david-griffith/HotWaterController/IO board/PCB_SolarController.png

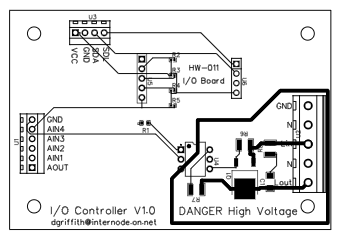
IO board/PCB_SolarController.png
