david-griffith/HotWaterController/IO board/SolarController 3D View.png

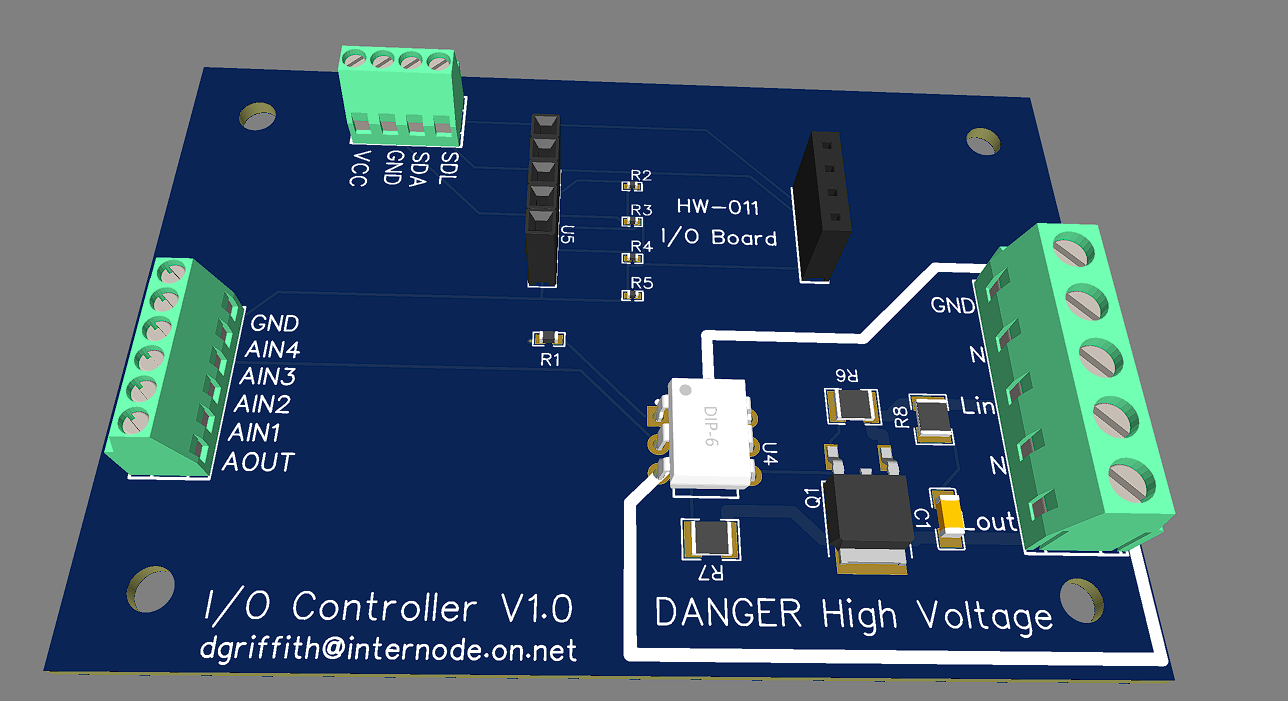
IO board/SolarController 3D View.png
