david-griffith/HotWaterController/IO board/BOM_PCB_SolarController_2_2023-12-30.csv

ID | Name | Designator | Footprint | Quantity | Manufacturer Part | Manufacturer | Supplier | Supplier Part | Price
1 | DB125-2.54-6P-GN | U1 | CONN-TH_DB125-2.54-6P-GN | 1 | DB125-2.54-6P-GN-S | DIBO(地博电气) | LCSC | C918124 | 0.547
2 | DW254R-11-04-85 | U6 | HDR-TH_4P-P2.54-V-F | 1 | DW254R-11-04-85 | DEALON(德艺隆) | LCSC | C2935898 | 0.05
3 | DB127V-5.0-5P-GN-S | U2 | CONN-TH_5P-P5.00_DB127V-5.0-5P-GN-S | 1 | DB127V-5.0-5P-GN-S | DIBO(地博电气) | LCSC | C430625 | 0.333
4 | DB125-2.54-4P-GN | U3 | CONN-TH_DB125-2.54-4P-GN | 1 | DB125-2.54-4P-GN-S | DIBO(地博电气) | LCSC | C918122 | 0.382
5 | DW254R-11-05-85 | U5 | CONN-TH_5P-P2.54_DEALON_DW254R-11-05-85 | 1 | DW254R-11-05-85 | DEALON(德艺隆) | LCSC | C2935899 | 0.055
6 | MOC3041M | U4 | DIP-6_L8.5-W6.4-P2.54-LS7.6-BL | 1 | MOC3041M | FAIRCHILD | LCSC | C8921 | 0.597
7 | 360Ω | R7 | R1210 | 1 | CR1210F360RP05 | Ever Ohms Tech | LCSC | C174466 | 0.016
8 | 330Ω | R6 | R1210 | 1 | 1210W2F3300T5E | UNI-ROYAL(Uniroyal Elec) | LCSC | C422327 | 0.01
9 | 1kΩ | R5,R4,R3,R2 | R0402 | 4 | PTFR0402B1K00N9 | ResistorToday | LCSC | C328418 | 0.124
10 | 160Ω | R1 | R0603 | 1 | AECR0603F160RK9 | ResistorToday | LCSC | C352364 | 0.005
11 | BT137S-800E_C2831693 | Q1 | TO-252-3_L6.5-W5.8-P4.60-LS9.9-BR | 1 | BT137S-800E | KY(韩景元) | LCSC | C2831693 | 0.117
12 | 33Ω | R8 | R1210 | 1 | 1210W2F330JT5E | Uniroyal Elec | LCSC | C407192 | 0.011
13 | 10nF | C1 | C1206 | 1 | GCM31B7U2E103JX01L | muRata(村田) | LCSC | C363962 | 0.134
