david-griffith/HotWaterController/IO board/Schematic_SolarController_2023-12-30.pdf

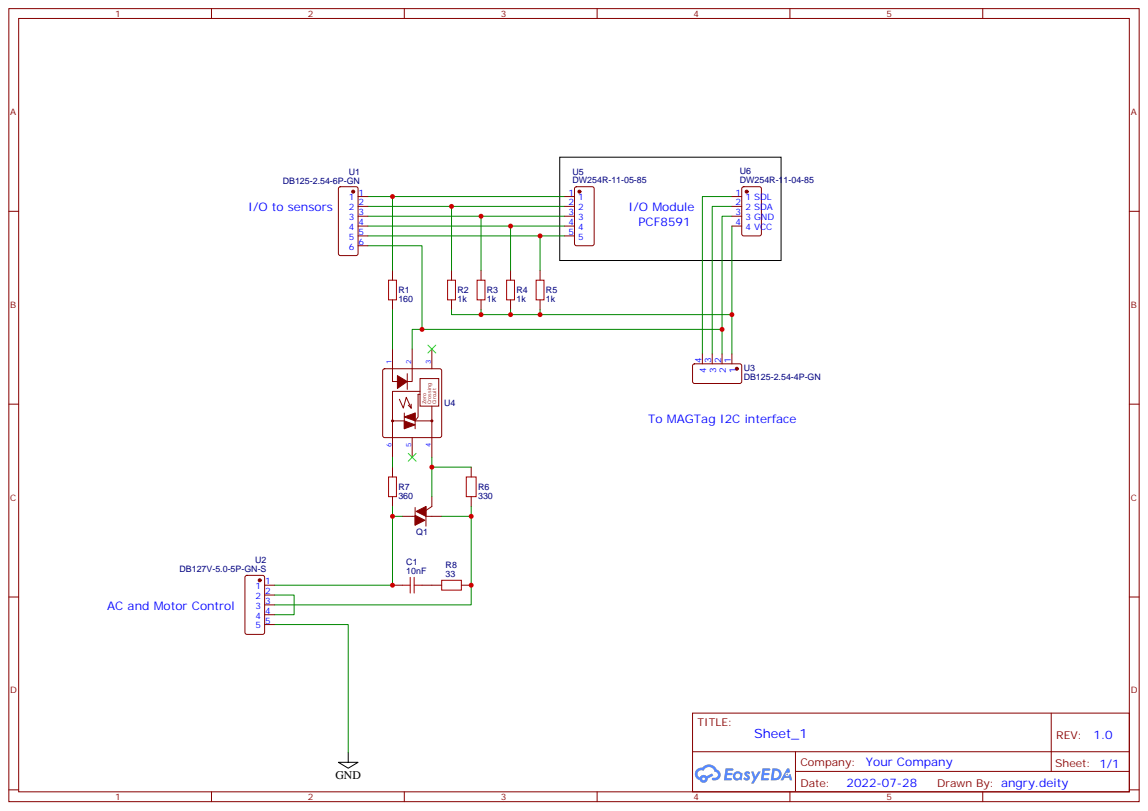
[picture p3: page 1]

AC and Motor Control

Drawn By: angry.deity
