david-griffith/HotWaterController/HotWaterController.ino

/* 
 HotWaterController program.
 Reads some analog sensors and controls a circulating pump to circulate water through solar collectors to efficiently heat a tank of water.
 A suite of Dallas Onewire sensors provide monitoring of other temperatures in the system.  
 We are using FreeRTOS to allow different tasks to run simultaneously.
 There is :
 A sensor reading task.
 A TFT display print task.
 A pump control task.
 A pump speed calculation task.
 A cloud update task.
*/
#include <FreeRTOS_SAMD51.h>
#include <SPI.h>
#include <WiFiNINA.h>
#include <OneWire.h>
#include <DallasTemperature.h>
#include <Adafruit_PCF8591.h>
#include "Adafruit_GFX.h"
#include "Adafruit_HX8357.h"
#include <ArduinoHA.h>

// Change the defines in this file to match your local settings!
#include "LocalSettings.h"

// A buffer for the task list in the loop function.
char ptrTaskList[250];

// OneWire bus is on pin 4
#define ONE_WIRE_BUS 4

// Reset the wifi module using pin 7
#define WIFI_RST 7

// PyPortal Titano TFT control
#define TFT_BACKLIGHT 25  // Set the backlight power
#define TFT_D0 34         // Data bit 0 pin (MUST be on PORT byte boundary)
#define TFT_WR 26         // Write-strobe pin (CCL-inverted timer output)
#define TFT_DC 10         // Data/command pin
#define TFT_CS 11         // Chip-select pin
#define TFT_RST 24        // Reset pin
#define TFT_RD 9          // Read-strobe pin
#define TFT_TE 12
Adafruit_HX8357 tft = Adafruit_HX8357(tft8bitbus, TFT_D0, TFT_WR, TFT_DC, TFT_CS, TFT_RST, TFT_RD);

// Mutex around print to avoid two threads trying to print at the same time.
SemaphoreHandle_t printMutex = xSemaphoreCreateMutex();
// Mutex around the ADC to avoid two threads accessing the PCF8591 chip at the same time.
SemaphoreHandle_t adcMutex = xSemaphoreCreateMutex();
// Mutex around the pumpSpeed variable to avoid the calculation and the pump drive threads from accessing the variable at the same time.
SemaphoreHandle_t speedMutex = xSemaphoreCreateMutex();

// Addesses of the oneWire sensors we are using.
// On bootup the program scans the bus and outputs these addresses on the serial port.
DeviceAddress owRoms[][8] = {
  { 0x28, 0xF7, 0xE2, 0x81, 0x94, 0x21, 0x06, 0x88 },
  { 0x28, 0xAB, 0x83, 0x7F, 0x94, 0x21, 0x06, 0x63 },
  { 0x28, 0xEE, 0x1D, 0xA2, 0x94, 0x21, 0x06, 0x74 },
  { 0x28, 0x62, 0xC7, 0x7F, 0x94, 0x21, 0x06, 0x9C },
  { 0x28, 0x7A, 0x5B, 0x85, 0x94, 0x21, 0x06, 0x9A },
};

// Sensor names.
// Ensure that the order of these names matches the owRom addresses above.
// Extra names are added on the end for the analog sensors and other bits of info.
char sensorNames[][40] = { "Ambient_Temperature",
                           "Outlet_Temperature",
                           "Inlet_Temperature",
                           "Panel_Inlet_Temperature",
                           "Panel_Outlet_Temperature",
                           "coldSensor",
                           "hotSensor",
                           "RSSI",
                           "pumpSpeed",
                           "wifiConnects",
                           "MQTTConnects",
                           "maxDiff" };

// The combined data from all sensors above is stored in this array.
float sensorData[12] = { 0, 0, 0, 0, 0, 0, 0, 0, 0, 0, 0, 0 };
// Pump speed from 0 to 100 percent.
uint8_t pumpSpeed = 0;
// Wifi stats.
uint16_t wifiConnects = 0;
uint16_t MQTTConnects = 0;
// Controller initial start and stop temperatures.
float START_MAX_DIFF = 8;
float START_MIN_DIFF = 4;


// Set up the A/D board
// This is actually a generic PCF8951 board I got off ebay running over I2C.
Adafruit_PCF8591 pcf = Adafruit_PCF8591();
#define ADC_REFERENCE_VOLTAGE 3.3

// Setup a oneWire instance to communicate with any OneWire devices (not just Maxim/Dallas temperature ICs)
OneWire oneWire(ONE_WIRE_BUS);

// Pass our oneWire reference to Dallas Temperature.
DallasTemperature sensors(&oneWire);

// Set up networking.
WiFiClient net;
HADevice device;
// MQTT subsystem
HAMqtt mqtt(net, device);

float sensorGet(const char* wantedName) {
  // A simple helper function to return the value given by the name
  // Just like a dictionary would.
  for (int i = 0; i < 12; i++) {
    if (strcmp(sensorNames[i], wantedName) == 0) return sensorData[i];
  }
  // Return nonsense value if not in the list.
  return -255;
}

void sensorSet(const char* sensorName, float sensorValue) {
  // Sets a value by it's name, like a dictionary.
  for (int i = 0; i < 12; i++) {
    if (strcmp(sensorNames[i], sensorName) == 0) {
      sensorData[i] = sensorValue;
    }
  }
}

float smooth(float smoothValue, float rawValue) {
  // returns a smoothed value by shifting the smoothed value 20 percent of the difference
  // between raw and smooth.
  // Initial load if smoothValue is zero
  if (smoothValue == 0.0) return rawValue * 0.95;
  float diff = rawValue - smoothValue;
  return smoothValue + (diff * 0.20);
}

// functions around Serial.println and print to avoid two threads talking at the same time.
void Println(const char* str) {
  // use instead of Println(char *str)
  xSemaphoreTake(printMutex, portMAX_DELAY);
  Serial.println(str);
  xSemaphoreGive(printMutex);
}

void Print(const char* str) {  // use instead of Serial.println(char *str)
  xSemaphoreTake(printMutex, portMAX_DELAY);
  Serial.print(str);
  xSemaphoreGive(printMutex);
}

static float lookupTemp(int rawValue) {
  // Converts the raw ADC value from the analog NTC thermistors to a temperature value.
  // On my board a 1k resistor pulls the ADC input towards VCC and their internal resistance pulls the ADC input towards ground.
  // Loss of connection gives therefore gives high ADC values which relate to temps below zero.
  // Uses interpolation between 17 lookup values. Didn't bother with negatives, it's not that cold where I live.
  // Put your own function here for your particular sensor, all I had was a table of resistances and temperatures to work with from the original manufacturer.
  float temp = -255;
  float tempsArray[] = { 0, 10, 20, 30, 40, 50, 60, 70, 80, 90, 100, 110, 120, 130, 140, 150, 160 };
  float rawValueArray[] = { 243.0, 238.0, 231.0, 222.0, 210.0, 197.0, 181.0, 164.0, 147.0, 125.0, 106.0, 89.0, 73.0, 48.0, 38.0 };
  if (rawValue <= rawValueArray[14]) return 255;
  if (rawValue >= rawValueArray[0]) return -5;

  for (int i = 1; i < 15; i++) {
    if (rawValue > rawValueArray[i]) {
      float perc = (rawValue - rawValueArray[i - 1]) / (rawValueArray[i] - rawValueArray[i - 1]);
      temp = tempsArray[i - 1] + perc * (tempsArray[i] - tempsArray[i - 1]);
      break;
    }
  }
  return temp;
}

void updateStartingDiff(HANumeric number, HANumber * sender) {
    if (!number.isSet()) {
        // the reset command was sent by Home Assistant, better set to default
        START_MAX_DIFF = 8;
    } else {
      START_MAX_DIFF = number.toFloat();
    }
    sender->setState(number);
}

void updateStoppingDiff(HANumeric number, HANumber * sender) {
    if (!number.isSet()) {
        // the reset command was sent by Home Assistant, better set to default
        START_MIN_DIFF = 4;
    } else {
      START_MIN_DIFF = number.toFloat();
    }
    sender->setState(number);
}

void logMQTTDisconnects() {
  // INCREMENT THE COUNTER
  MQTTConnects++;
  Println("MQTT disconnect seen");
}

void connectWifi() {
  do {
    WiFi.end();
    Println("WiFi resetting and connecting...");
    pinMode(WIFI_RST, OUTPUT);
    digitalWrite(WIFI_RST, HIGH);
    vTaskDelay(100 / portTICK_PERIOD_MS);
    digitalWrite(WIFI_RST, LOW);
    vTaskDelay(100 / portTICK_PERIOD_MS);
    digitalWrite(WIFI_RST, HIGH);
    vTaskDelay(1000 / portTICK_PERIOD_MS);
    wifiConnects++;
    WiFi.begin(MY_SSID, WIFI_PASSWORD);
    // Check if connected and if not wait 5 seconds and we'll loop again.
    if (WiFi.status() != WL_CONNECTED || WiFi.RSSI() > -1) {
      Println("Failed Wi-Fi connection. Retrying...");
      vTaskDelay(5000 / portTICK_PERIOD_MS);
    }
  } while (WiFi.status() != WL_CONNECTED || WiFi.RSSI() > -1);
  Println("WiFi Connected");
}


static void updateMQTT(void* pvParameters) {
  // Sends data to the MQTT server for Home Assistant every 5 seconds.
  Println("Starting MQTT/HA task");
  device.setModel(_MODEL);
  device.setSoftwareVersion(_VERSION);
  device.setManufacturer(_MANUF);
  device.setName(_NAME);
  device.setUniqueId(_MAC, sizeof(_MAC));
  device.enableSharedAvailability();
  device.enableLastWill();
  mqtt.setBufferSize(1024); // set the buffer size to 512 bytes, default is 256 bytes
  mqtt.setKeepAlive(120);
  mqtt.onDisconnected(logMQTTDisconnects); // Update the counter on disconect
  mqtt.begin(mqtt_server, mqtt_server_port, nullptr, nullptr);
  connectWifi();

// Sensor config
  HASensorNumber ambientTempSensor("Ambient_Temperature",HASensorNumber::PrecisionP1);
  ambientTempSensor.setName("Ambient Temperature");
  ambientTempSensor.setUnitOfMeasurement("°C");
  ambientTempSensor.setIcon("mdi:thermometer");
  ambientTempSensor.setStateClass("measurement");
  HASensorNumber tankOutletSensor("Tank_Outlet_Temperature",HASensorNumber::PrecisionP1);
  tankOutletSensor.setName("Tank Outlet Temperature");
  tankOutletSensor.setUnitOfMeasurement("°C");
  tankOutletSensor.setIcon("mdi:thermometer");
  tankOutletSensor.setStateClass("measurement");
  HASensorNumber tankInletSensor("Tank_Inlet_Temperature",HASensorNumber::PrecisionP1);
  tankInletSensor.setName("Tank Inlet Temperature");
  tankInletSensor.setUnitOfMeasurement("°C");
  tankInletSensor.setIcon("mdi:thermometer");
  tankInletSensor.setStateClass("measurement");
  HASensorNumber panelInletSensor("Panel_Inlet_Temperature", HASensorNumber::PrecisionP1);
  panelInletSensor.setName("Panel Inlet Temperature");
  panelInletSensor.setUnitOfMeasurement("°C");
  panelInletSensor.setIcon("mdi:thermometer");
  panelInletSensor.setStateClass("measurement");
  HASensorNumber panelOutletSensor("Panel_Outlet_Temperature", HASensorNumber::PrecisionP1);
  panelOutletSensor.setName("Panel Outlet Temperature");
  panelOutletSensor.setUnitOfMeasurement("°C");
  panelOutletSensor.setIcon("mdi:thermometer");
  panelOutletSensor.setStateClass("measurement");
  HASensorNumber analogColdSensor("Analog_Cold_Sensor", HASensorNumber::PrecisionP1);
  analogColdSensor.setName("Analog Cold Sensor");
  analogColdSensor.setUnitOfMeasurement("°C");
  analogColdSensor.setIcon("mdi:thermometer");
  analogColdSensor.setStateClass("measurement");
  HASensorNumber analogHotSensor("Analog_Hot_Sensor", HASensorNumber::PrecisionP1);
  analogHotSensor.setName("Analog Hot Sensor");
  analogHotSensor.setIcon("mdi:thermometer");
  analogHotSensor.setUnitOfMeasurement("°C");
  analogColdSensor.setStateClass("measurement");
  HASensorNumber RSSISensor("RSSI");
  RSSISensor.setName("RSSI");
  RSSISensor.setUnitOfMeasurement("dBm");
  RSSISensor.setIcon("mdi:wifi");
  RSSISensor.setStateClass("measurement");
  HASensorNumber pumpSpeedSensor("Pump_Speed");
  pumpSpeedSensor.setName("Pump Speed");
  pumpSpeedSensor.setUnitOfMeasurement("%");
  pumpSpeedSensor.setIcon("mdi:pump");
  pumpSpeedSensor.setStateClass("measurement");
  HASensorNumber wifiConnectsSensor("WiFi_Connects");
  wifiConnectsSensor.setName("WiFi Connects");
  wifiConnectsSensor.setStateClass("measurement");
  HASensorNumber mqttConnectsSensor("MQTT_Connects");
  mqttConnectsSensor.setName("MQTT Connects");
  mqttConnectsSensor.setStateClass("measurement");
  HASensorNumber maxTempDiffSensor("Max_Temp_Diff",HASensorNumber::PrecisionP1);
  maxTempDiffSensor.setName("Max Temp Diff");
  maxTempDiffSensor.setUnitOfMeasurement("°C");
  maxTempDiffSensor.setStateClass("measurement");
  HASensorNumber stackHiWater("StackHighWaterMark");
  stackHiWater.setName("Stack High Water Mark");
  stackHiWater.setStateClass("measurement");

  // Number controls for start / stop temps
  HANumber startingDiff("startingDiff");
  startingDiff.setName("Starting Temp Diff");
  startingDiff.setMin(1);
  startingDiff.setMax(25);
  startingDiff.setMode(HANumber::ModeBox);
  startingDiff.setDeviceClass("temperature");
  startingDiff.onCommand(updateStartingDiff);
  startingDiff.setCurrentState(START_MAX_DIFF);
  HANumber stoppingDiff("stoppingDiff");
  stoppingDiff.setName("Stopping Temp Diff");
  stoppingDiff.setMin(1);
  stoppingDiff.setMax(25);
  stoppingDiff.setMode(HANumber::ModeBox);
  stoppingDiff.setDeviceClass("temperature");
  stoppingDiff.onCommand(updateStoppingDiff);
  stoppingDiff.setCurrentState(START_MIN_DIFF);
  // Set sensor values and loop endlessly.
  while (1) {
    // Check wifi status, disconnect MQTT and reconnect if unavailable
    if (WiFi.status() != WL_CONNECTED || WiFi.RSSI() > -1) {
      Println("Wifi connection lost.");
      // Let's start again.
      connectWifi();
    }
    ambientTempSensor.setValue(sensorData[0]);
    tankOutletSensor.setValue(sensorData[1]);
    tankInletSensor.setValue(sensorData[2]);
    panelInletSensor.setValue(sensorData[3]);
    panelOutletSensor.setValue(sensorData[4]);
    analogColdSensor.setValue(sensorData[5]);
    analogHotSensor.setValue(sensorData[6]);
    RSSISensor.setValue(WiFi.RSSI());
    pumpSpeedSensor.setValue(sensorData[8]);
    wifiConnectsSensor.setValue(wifiConnects);
    mqttConnectsSensor.setValue(MQTTConnects);
    maxTempDiffSensor.setValue(sensorData[11]);
    stackHiWater.setValue(uxTaskGetStackHighWaterMark( NULL ));
    Println("Loop...");
    // A connection is automatically established in loop().
    mqtt.loop();
    if (mqtt.getState() != 0) {
      Println("MQTT state not normal");
    }
    vTaskDelay(5000 / portTICK_PERIOD_MS);
  }
}

static void readSensors(void* pvParameters) {
  // Read the onewire and analog sensors every two seconds.
  char buffer[40];
  DeviceAddress myDevice;
  while (1) {
    Print("Read Sensors...");
    // Print("Requesting temperatures...");
    sensors.requestTemperatures();  // Send the command to get temperatures
    Print("Temps requested....");
    vTaskDelay(800 / portTICK_PERIOD_MS);
    for (int i = 0; i < sizeof(owRoms) / sizeof(owRoms[0]); i++) {
      float tempC = sensors.getTempC(*owRoms[i]);
      if (tempC == DEVICE_DISCONNECTED_C) {
        continue;
      }
      sensorData[i] = tempC;
    }
    Print("Looking up analog values....");
    // Fill in the analog values. Mutex around all the pcf commands as we're driving the output concurrently.
    xSemaphoreTake(adcMutex, portMAX_DELAY);
    sensorData[5] = smooth(sensorData[5], lookupTemp(pcf.analogRead(0)));
    sensorData[6] = smooth(sensorData[6], lookupTemp(pcf.analogRead(1)));
    xSemaphoreGive(adcMutex);
    // Wifi RSSI is updated in the updateMQTT task to keep all the wifi access in there.
    sensorData[8] = pumpSpeed;
    sensorData[9] = wifiConnects;
    sensorData[10] = MQTTConnects;
    Println("all read!");
    vTaskDelay(2000 / portTICK_PERIOD_MS);
  }
}

static void drivePump(void* pvParameters) {
  // Drive the pump at a rate consistent with the global pumpSpeed.
  //
  const float PWM_TIME = 5;
  char tempBuf[10];

  // Just switch the DAC 0/255 to correspond with the proportional on/off time.
  while (1) {
    Print(" Drive Pump: ");
    // work out on and off times
    xSemaphoreTake(speedMutex, portMAX_DELAY);
    uint32_t offTime = (100.0 - pumpSpeed) / 100.0 * PWM_TIME * 1000;
    uint32_t onTime = (pumpSpeed / 100.0) * PWM_TIME * 1000;
    xSemaphoreGive(speedMutex);
    itoa(onTime, tempBuf, 10);
    Print(tempBuf);
    Print(" ");
    itoa(offTime, tempBuf, 10);
    Println(tempBuf);
    // Mutexs around PCF access as we're reading concurrently
    xSemaphoreTake(adcMutex, portMAX_DELAY);
    pcf.analogWrite(255);
    xSemaphoreGive(adcMutex);
    vTaskDelay(onTime / portTICK_PERIOD_MS);
    xSemaphoreTake(adcMutex, portMAX_DELAY);
    pcf.analogWrite(0);
    xSemaphoreGive(adcMutex);
    vTaskDelay(offTime / portTICK_PERIOD_MS);
  }
}

static void calcPumpSpeed(void* pvParameters) {
  // Look at sensor data, calculate pump speed.
  // In general:
  // Switch on when hotSensor - coldSensor > START_MAX_DIFF
  // Switch off when hotSensor - coldSensor < START_MIN_DIFF
  // ramp from 20 to 100 percent in between START_MIN_DIFF and START_MAX_DIFF.
  // If we are above initial maxDiff, increase maxDiff for this run to throttle back the pump drive and get higher collector temps.
  // Run the pump for an extra minute if hotSensor - coldSensor < minDiff using a countdown timer, reset if temps warm back up.
  bool pumpTriggered = false;
  bool overTemp = false;
  bool countdownRunning = false;
  int countdown = 30;
  // maxDiff initially starts at this value
  float maxDiff = START_MAX_DIFF;

  while (1) {
    Println("CalcPumpSpeed");
    float tempDiff = sensorGet("hotSensor") - sensorGet("coldSensor");
    // Turn on the pump if the tempDiff rises above maxDiff.
    // If we were on a countdown, reset it.
    if (tempDiff > maxDiff) {
      pumpTriggered = true;
      countdownRunning = false;
      countdown = 30;
    } else if (tempDiff > 1 && !countdownRunning) {
      // Run the pump at a slow rate if the temperature difference is minor
      // This is to bring a little bit of water out to the sensor for better readings
      // with low sun input as it's not directly in the collector
      xSemaphoreTake(speedMutex, portMAX_DELAY);
      pumpSpeed = 20;
      xSemaphoreGive(speedMutex);
    } else if (!countdownRunning) {
      // No trigger conditions met and no countdown active: stop pump.
      pumpTriggered = false;
      xSemaphoreTake(speedMutex, portMAX_DELAY);
      pumpSpeed = 0;
      xSemaphoreGive(speedMutex);
    }
    // If countdownRunning, fall through — the countdown block below manages pump state.
    // If things are proper hot turn the pump on regardless.
    if (sensorGet("hotSensor") > 100.0) pumpTriggered = true;

    // Flush: when temp diff drops below minimum, run pump at full speed for a countdown period
    // to push remaining warm water from the collector pipework into the tank.
    // Useful on marginal solar days where only a small amount of water leaves the collector.
    if (tempDiff < START_MIN_DIFF) {
      xSemaphoreTake(speedMutex, portMAX_DELAY);
      // Trigger the countdown only if the pump is currently running.
      if (pumpTriggered == true) {
        countdownRunning = true;
        pumpSpeed = 100;
        pumpTriggered = false;
        maxDiff = START_MAX_DIFF;
      }
      // While countdown running, decrement counter
      if (countdownRunning == true) {
        countdown--;
        // Hit zero, turn pump off and reset counter.
        if (countdown == 0) {
          pumpSpeed = 0;
          countdown = 30;
          countdownRunning = false;
        }
      }
      xSemaphoreGive(speedMutex);
    }

    if (pumpTriggered == true) {
      // Wrap pumpspeed in a mutex so we don't read it in DrivePump while setting it.
      xSemaphoreTake(speedMutex, portMAX_DELAY);
      if (tempDiff > maxDiff) {
        // Flat out.
        pumpSpeed = 100;
        // Slowly increase maxDiff while we are still above it.
        // This should throttle back the pump and increase collector output temp
        maxDiff = maxDiff * 1.02;
      } else {
        pumpSpeed = ((tempDiff - START_MIN_DIFF) / (maxDiff - START_MIN_DIFF)) * 100;
        // Set limits to stop small pulses, don't bother below 10 percent either ( PWM of 5 seconds gives 0.5 sec on time at 10%)
        if (pumpSpeed > 90) pumpSpeed = 100;
        // If pumpSpeed drops below 70 percent start winding down maxDiff again, a bit quicker than we wound up.
        if (pumpSpeed < 70) maxDiff = maxDiff * 0.96;
        if (pumpSpeed < 10) pumpSpeed = 0;
      }
      xSemaphoreGive(speedMutex);
    } else {
      // Pump isn't running so we're just looping to see if temps change enough to start.
      // if START_MAX_DIFF has changed, update maxDiff accordingly, otherwise we'd have to go through a pump cycle to change it.
      if (START_MAX_DIFF != maxDiff) maxDiff = START_MAX_DIFF;
    }

    // Overtemp cool-down mode.
    // Triggered when cold sensor gets over 70 degrees at any time.
    // Wait until hot sensor is more than 30 degrees below cold sensor and turn pump on.
    // Once cold sensor gets down to 60 degrees turn pump off and reset overTemp.
    if (sensorGet("coldSensor") > 70.0) overTemp = true;
    if (overTemp == true) {
      if (sensorGet("coldSensor") - sensorGet("hotSensor") > 30) {
        xSemaphoreTake(speedMutex, portMAX_DELAY);
        pumpSpeed = 100;
        xSemaphoreGive(speedMutex);
      }
      if (sensorGet("coldSensor") < 60.0) {
        xSemaphoreTake(speedMutex, portMAX_DELAY);
        pumpSpeed = 0;
        xSemaphoreGive(speedMutex);
        overTemp = false;
      }
    }
    sensorData[11] = maxDiff;
    vTaskDelay(2000 / portTICK_PERIOD_MS);
  }
}

static void updateScreen(void* pvParameters) {
  // Sets up the display and then updates it.
  // Note that DMA is turned off in Adafruit_SPITFT.h, it doesn't play well with FreeRTOS it seems.

  String screenNames[] = { "Ambient", "Tank Outlet", "Tank Inlet", "Collector In", "Collector Out", "Cold Sensor", "Collector Top", "RSSI", "Pump Drive", "Wifi Connects", "MQTT Connects", "Max Diff" };
  Print("Setting up display...");
  // Turn on the backlight and reset the TFT.
  pinMode(TFT_BACKLIGHT, OUTPUT);
  digitalWrite(TFT_BACKLIGHT, HIGH);
  pinMode(TFT_RST, OUTPUT);
  digitalWrite(TFT_RST, HIGH);
  vTaskDelay(10 / portTICK_PERIOD_MS);
  digitalWrite(TFT_RST, LOW);
  vTaskDelay(10 / portTICK_PERIOD_MS);
  digitalWrite(TFT_RST, HIGH);
  vTaskDelay(10 / portTICK_PERIOD_MS);
  tft.begin();
  tft.setRotation(3);
  tft.fillScreen(0x0000);
  tft.setTextSize(2);
  tft.setTextColor(HX8357_GREEN);
  tft.setTextWrap(true);
  // Loop through the screen names and print them down the side of the screen.
  for (int i = 0; i < 12; i++) {
    tft.setCursor(0, i * 20);
    tft.print(screenNames[i]);
  }
  Println("Done.");

  // Updates the screen with all the values in the sensorData array every five seconds.
  while (1) {
    Println("Update Screen");
    for (int i = 0; i < 12; i++) {
      tft.setCursor(200, i * 20);
      tft.fillRect(200, i * 20, 90, i * 20 + 20, 0x0000);
      tft.print(sensorGet(sensorNames[i]));
    }
    vTaskDelay(5000 / portTICK_PERIOD_MS);
  }
}

void findDevices() {
  // Finds oneWire devices. Runs once on boot.
  uint8_t address[8];
  uint8_t count = 0;
  if (oneWire.search(address)) {
    Serial.println("Devices found:");
    do {
      count++;
      Println("  {");
      for (uint8_t i = 0; i < 8; i++) {
        Print("0x");
        if (address[i] < 0x10) Print("0");
        Serial.print(address[i], HEX);
        if (i < 7) Print(", ");
      }
      Serial.println("  },");
    } while (oneWire.search(address));

    Serial.println("");
    Serial.print("// nr devices found: ");
    Serial.println(count);
  }
}

void setup() {


  // Uncomment this if you want to debug and catch the first few lines of output, but the USB serial is pretty quick to connect after flashing anyway
  // while(!Serial);

  // Kick start the I/O board
  pcf.begin();
  pcf.enableDAC(true);

  // Set up Onewire sensors
  findDevices();
  sensors.begin();
  // We'll wait ourselves for the result.
  sensors.setWaitForConversion(false);

  // Create tasks and allocate stack space to each one.
  // Each task has the same priority.
  xTaskCreate(updateMQTT, "MQTT", 8192, NULL, 1, NULL);
  xTaskCreate(readSensors, "readData", 512, NULL, 1, NULL);
  xTaskCreate(drivePump, "doPump", 512, NULL, 1, NULL);
  xTaskCreate(calcPumpSpeed, "pumpSpeed", 512, NULL, 1, NULL);
  xTaskCreate(updateScreen, "updateScreen", 512, NULL, 1, NULL);
  // Let's get this party started.
  vTaskStartScheduler();
}

void loop() {
  // This just prints the available stack space in the FreeRTOS idle task (loop in arduino)
  // If stack space gets to zero things will crash. The TaskCreate settings above are fine.
  // There's plenty of ram to go around in the PyPortal Titano

  Println("Looping in the Idle Task.");
  vTaskList(ptrTaskList);
  Println("*******************************************");
  Println("Task         State   Prio    Stack    Num");
  Println("*******************************************");
  Print(ptrTaskList);
  Println("*******************************************");
  /*
  size_t xFreeHeapSpace = xPortGetFreeHeapSize();
  xSemaphoreTake(printMutex, portMAX_DELAY);
  Serial.printf("Free Heap Space : %d \n", xFreeHeapSpace);
  xSemaphoreGive(printMutex);
  */
  delay(10000);
}
