david-griffith/HotWaterController/(commit log)

2023-12-30 I/O board info
    Upload I/O board schematic / gerber / BOM
    [BOM_PCB_SolarController_2_2023-12-30.csv]
2023-12-30 Split out local settings
    Split out wifi settings, MQTT server and API key , and controller start/stop temperatures.
2023-12-30 Shift I/O board files to a separate folder
    [BOM_PCB_SolarController_2_2023-12-30.csv]
2024-01-01 Add MQTT disconnect and loop
    Add a MQTT disconnect before reconnect.
    Add MQTT client loop in the cloud update task to avoid possibly getting publish queue stall, we don't do anything with published data.
    [HotWaterController.ino]
2024-01-02 Minor fixes
    Change direct comparison to RSSI.
    Change declaration to remove compiler warning.
    [HotWaterController.ino]
2024-01-03 Add mutex around SPI access
    TFT and Wifi both use SPI. Put a mutex around the regular TFT and Wifi/MQTT commands.
2024-01-12 Wrap MQTT client calls in SPI mutex
2024-02-21 Added another mutex in connectWiFi
    status and RSSI in the while statement weren't protected by the SPI mutex. This lead to occasional lockups if the display updated while we were looping in connectWifi looking for a connection.
2024-02-22 Shuffle TFT init code around, remove SPI mutex
    Re-reading the docs for the Titano show that it exclusively uses a parallel connection for the TFT. Removed SPI mutex around Wifi/TFT calls. Shifted TFT init code into FreeRTOS task as it would not update the display with the init and update code split between pre- and post- FreeRTOS initialisation.
2024-02-23 Adjust MQTT connection startup, shift all wifi-related functions to updateCloud task
    Bring wifi init into MQTT function, removed delays after connections, and tidy up logic a little.
    Shift all wifi related functions into the updateCloud task to avoid two tasks talking to the wifi module at the same time.
    [HotWaterController.ino]
2024-03-01 Purge the collector output line when shutting the pump off
    When there is low solar input, the pump often cycles for just a few minutes before shutting off for 5-10 minutes. My installation has long pipes (>10m) to the collectors, and a reasonable amount of warm water cools back down in the line before the pump starts again. This change adds a "line purge" to the pump shutdown, running the pump at 100 percent for 60 seconds.
2026-06-17 Remove vendored libraries (Adafruit_GFX, HX8357, PCF8591, DallasTemperature, FreeRTOS_SAMD51, MQTT, OneWire, WiFiNINA)
    Libraries should be installed via the Arduino Library Manager rather than vendored in the repo.
